AFB9900/iturover-buck-converter/Gorseller/Kart_ustten.png

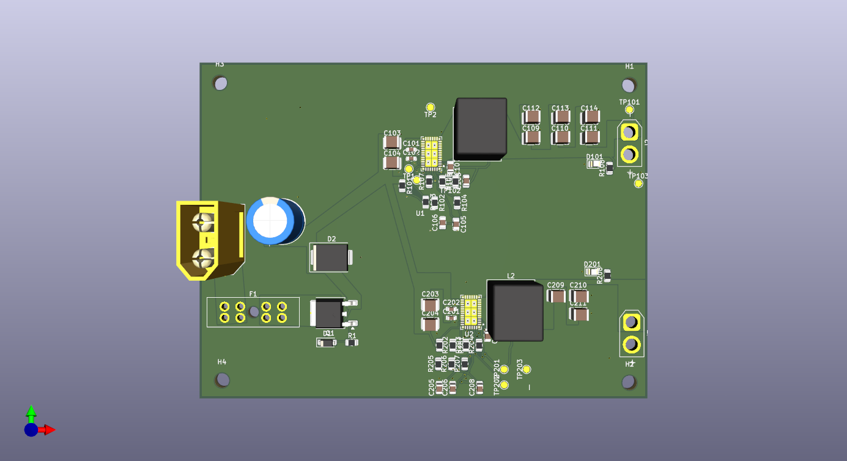
Gorseller/Kart_ustten.png
