AFB9900/iturover-buck-converter/Simulasyon/sim12_acilis_7m.png

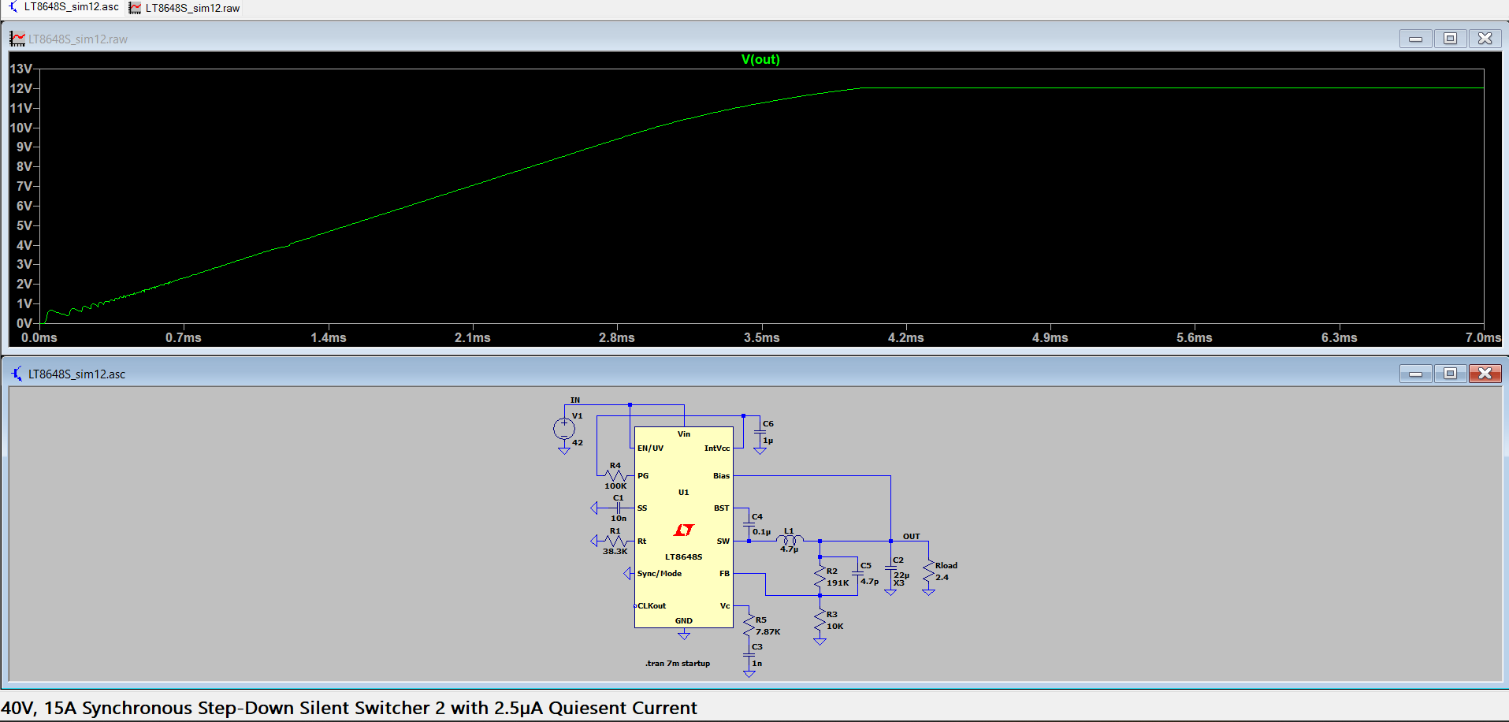
Simulasyon/sim12_acilis_7m.png
