AFB9900/iturover-buck-converter/Simulasyon/sim12_sonuc.png

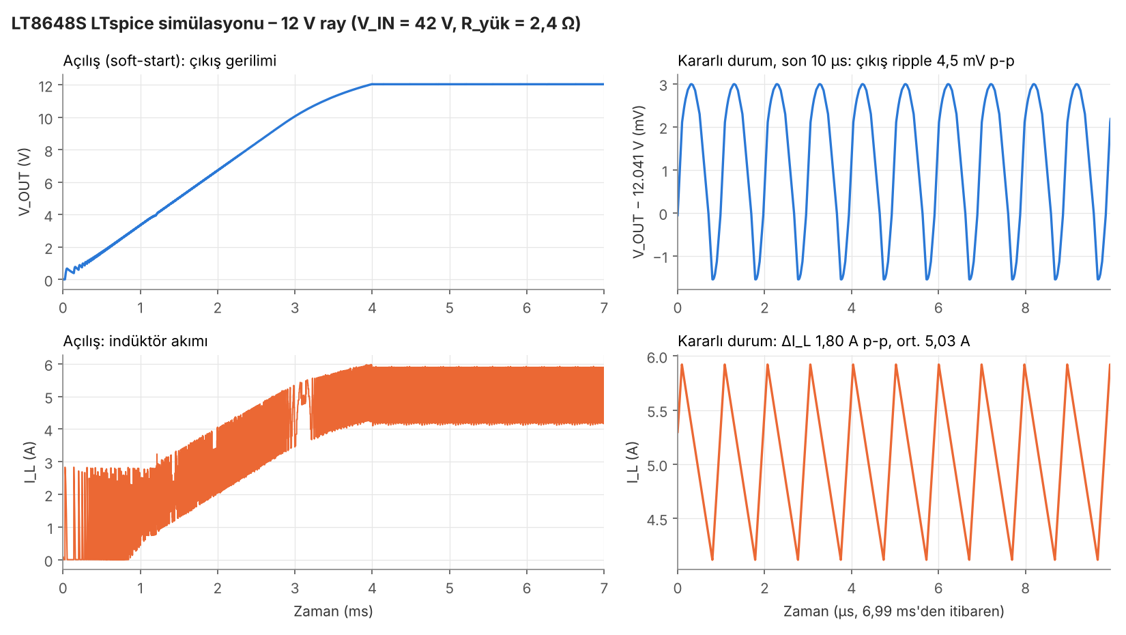
Simulasyon/sim12_sonuc.png
