AFB9900/iturover-buck-converter/Simulasyon/sim24_acilis_7m.png

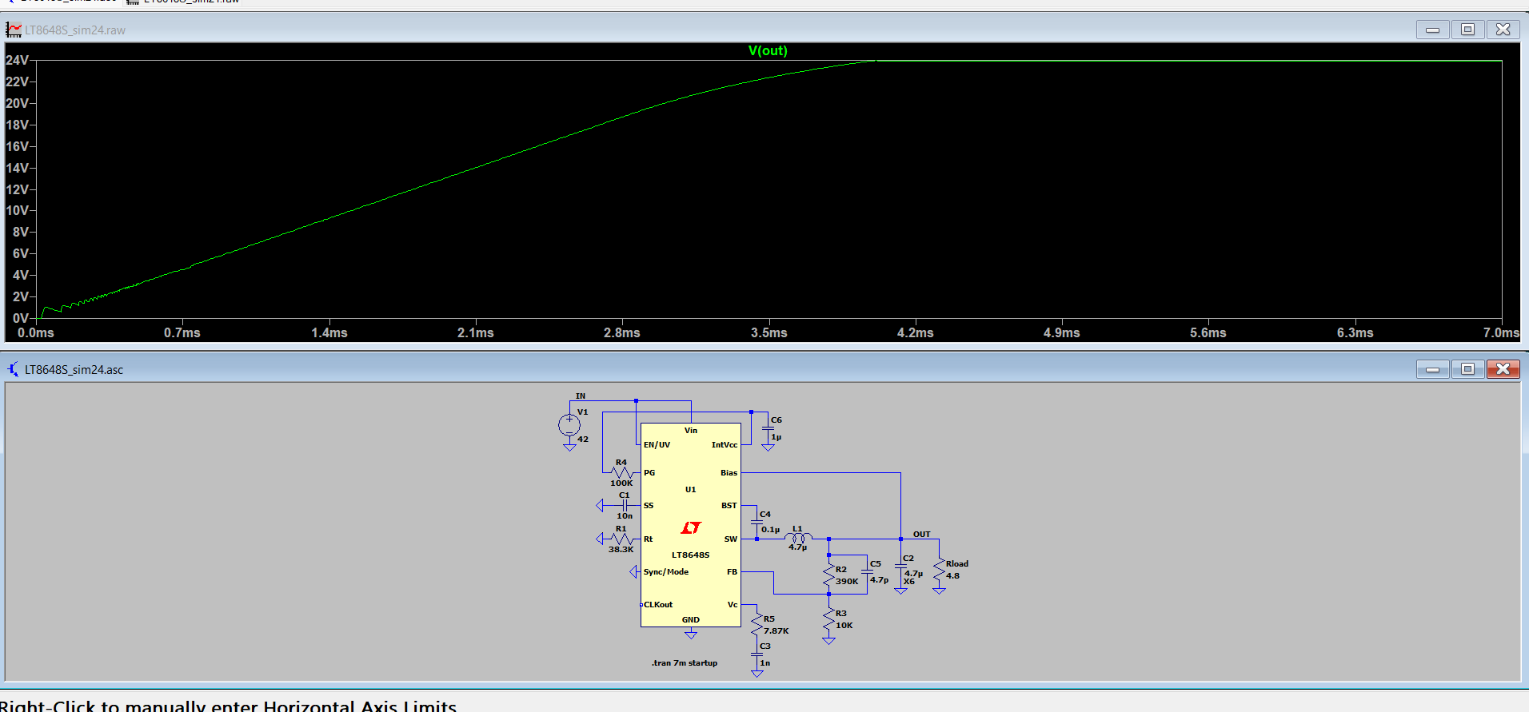
Simulasyon/sim24_acilis_7m.png
