AFB9900/iturover-buck-converter/Uretim_Dosyalari/BOM.csv

Reference | Qty | Value | DNP | Exclude from BOM | Exclude from Board | Footprint | Datasheet
C1 | 1 | 100u 63V |  |  |  | Capacitor_THT:CP_Radial_D10.0mm_P5.00mm | ~
C101,C102,C201,C202 | 4 | 100n 100V X7R |  |  |  | Capacitor_SMD:C_0603_1608Metric | ~
C103,C104,C109,C110,C111,C112,C113,C114,C203,C204 | 10 | 4.7u 50V X7R |  |  |  | Capacitor_SMD:C_1210_3225Metric | ~
C105,C205 | 2 | 10n |  |  |  | Capacitor_SMD:C_0805_2012Metric | ~
C106,C206 | 2 | 1n C0G |  |  |  | Capacitor_SMD:C_0805_2012Metric | ~
C107,C207 | 2 | 1u X7R |  |  |  | Capacitor_SMD:C_0805_2012Metric | ~
C108,C208 | 2 | 4.7p C0G |  |  |  | Capacitor_SMD:C_0805_2012Metric | ~
C209,C210,C211 | 3 | 22u 25V X7R |  |  |  | Capacitor_SMD:C_1210_3225Metric | ~
D1 | 1 | MMSZ5242B 12V |  |  |  | Diode_SMD:D_SOD-123 | ~
D2 | 1 | SMCJ43A |  |  |  | Diode_SMD:D_SMC | ~
D101,D201 | 2 | Yesil LED |  |  |  | LED_SMD:LED_0805_2012Metric | ~
F1 | 1 | 10A ATO |  |  |  | Fuse:FuseHolder_Blade_ATO_Littelfuse_FLR_178.6165 | ~
H1,H2,H3,H4 | 4 | M3 |  |  |  | MountingHole:MountingHole_3.2mm_M3 | ~
J1 | 1 | XT60 batarya girisi (pin1 = +) |  |  |  | Connector_AMASS:AMASS_XT60-M_1x02_P7.20mm_Vertical | ~
J2 | 1 | XT30 24V cikis (pin1 = +) |  |  |  | Connector_AMASS:AMASS_XT30U-F_1x02_P5.0mm_Vertical | ~
J3 | 1 | XT30 12V cikis (pin1 = +) |  |  |  | Connector_AMASS:AMASS_XT30U-F_1x02_P5.0mm_Vertical | ~
L1,L2 | 2 | 4.7u XAL1010-472ME |  |  |  | Inductor_SMD:L_Coilcraft_XAL1010-XXX | ~
Q1 | 1 | SQD50P06-15L |  |  |  | Package_TO_SOT_SMD:TO-252-2 | ~
R1 | 1 | 22k |  |  |  | Resistor_SMD:R_0805_2012Metric | ~
R101,R201 | 2 | 274k 1% |  |  |  | Resistor_SMD:R_0805_2012Metric | ~
R102,R106,R202,R206 | 4 | 10k 1% |  |  |  | Resistor_SMD:R_0805_2012Metric | ~
R103,R203 | 2 | 38.3k 1% |  |  |  | Resistor_SMD:R_0805_2012Metric | ~
R104,R204 | 2 | 7.87k |  |  |  | Resistor_SMD:R_0805_2012Metric | ~
R105 | 1 | 390k 1% |  |  |  | Resistor_SMD:R_0805_2012Metric | ~
R107,R207 | 2 | 100k |  |  |  | Resistor_SMD:R_0805_2012Metric | ~
R108 | 1 | 10k |  |  |  | Resistor_SMD:R_0805_2012Metric | ~
R205 | 1 | 191k 1% |  |  |  | Resistor_SMD:R_0805_2012Metric | ~
R208 | 1 | 4.7k |  |  |  | Resistor_SMD:R_0805_2012Metric | ~
TP1 | 1 | VIN |  |  |  | TestPoint:TestPoint_Pad_D1.5mm | ~
TP2,TP103,TP203 | 3 | GND |  |  |  | TestPoint:TestPoint_Pad_D1.5mm | ~
TP101 | 1 | 24V |  |  |  | TestPoint:TestPoint_Pad_D1.5mm | ~
TP102,TP202 | 2 | PG |  |  |  | TestPoint:TestPoint_Pad_D1.5mm | ~
TP201 | 1 | 12V |  |  |  | TestPoint:TestPoint_Pad_D1.5mm | ~
U1,U2 | 2 | LT8648S |  |  |  | LT8648S:IC_LT8648SEV_TRPBF | https://s3.amazonaws.com/snapeda/datasheet/LT8648SEV_TRPBF_Analog_Devices-_Inc.pdf
