AFB9900/iturover-buck-converter/Gorseller/Sematik.pdf

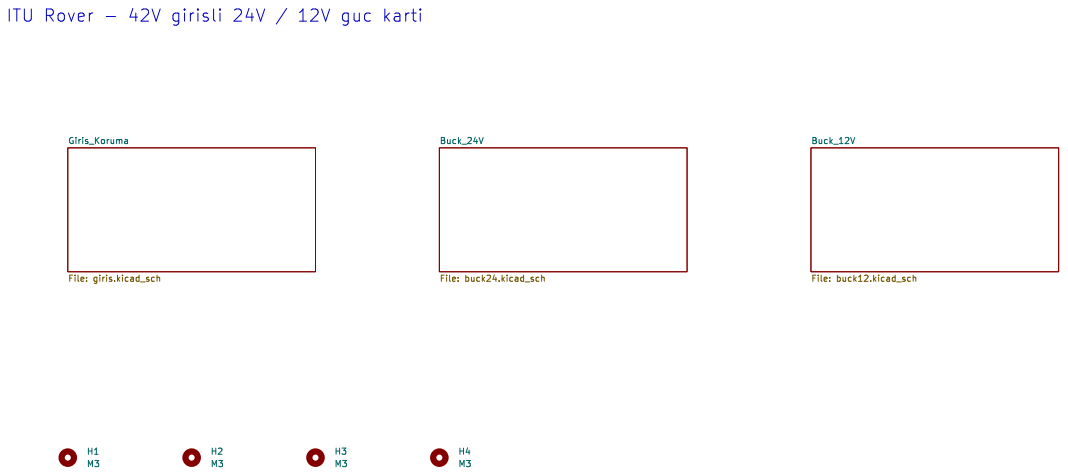
[picture p17: page 1]

Id: 1/4 Title: Guc karti - ana sayfa

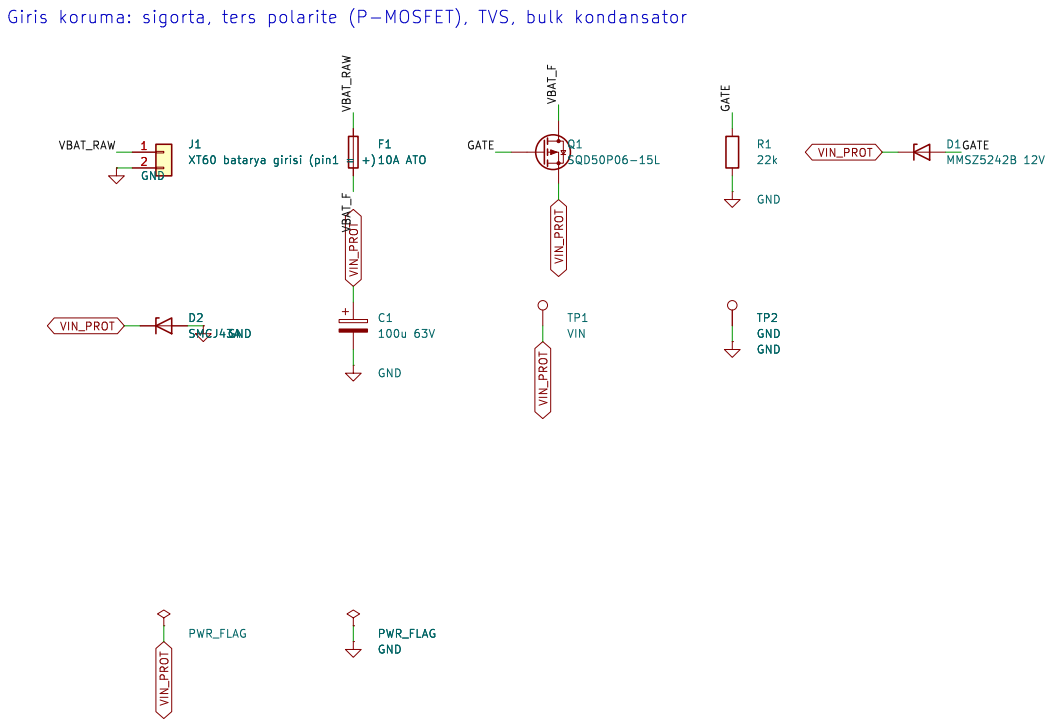
[picture p18: page 2]

File: giris.kicad_sch Sheet: /Giris_Koruma/
Id: 2/4 Title: Giris koruma

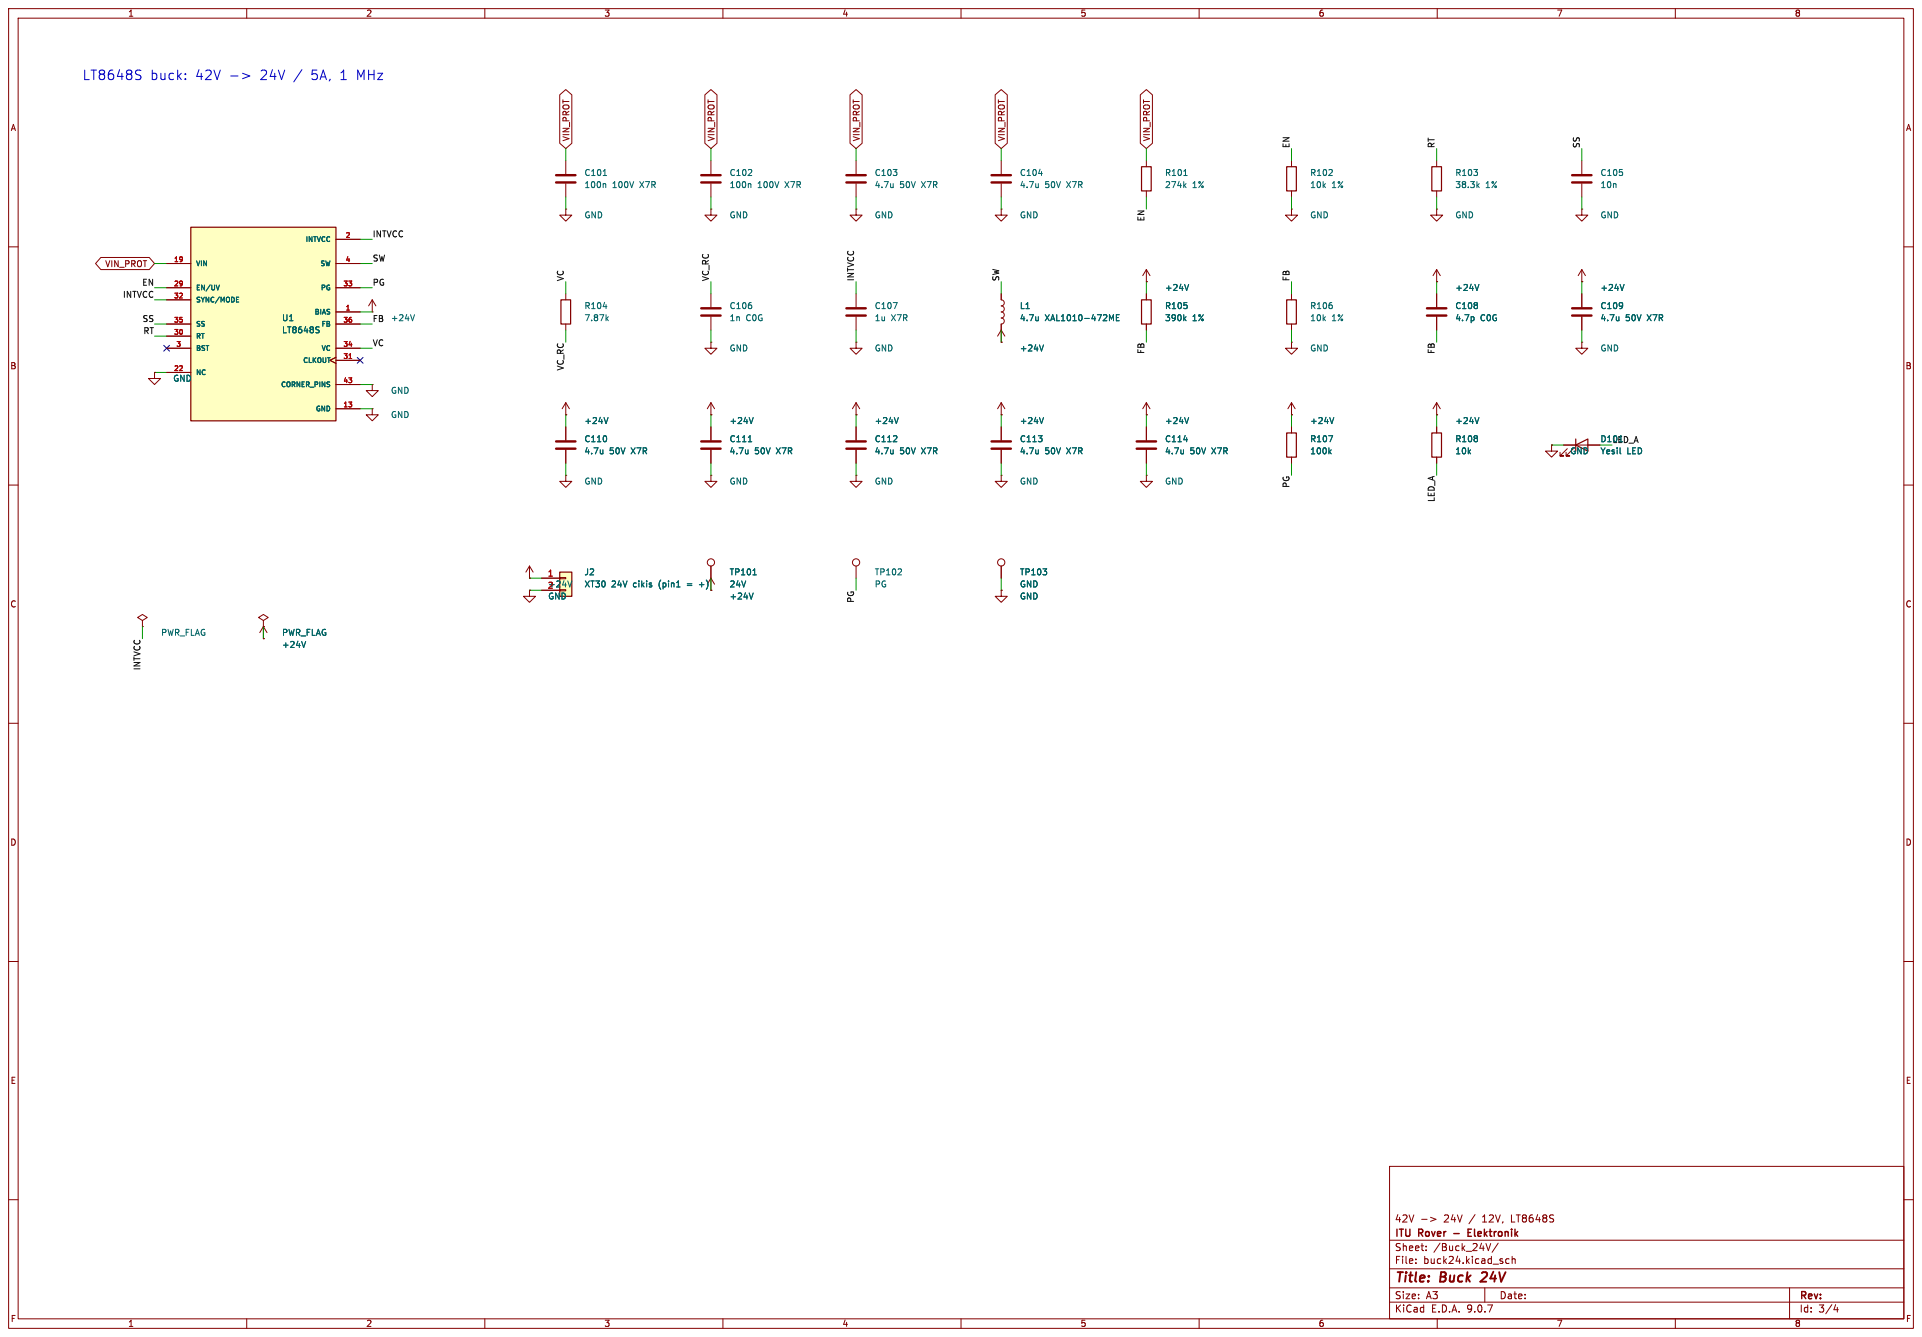
[picture p19: page 3]

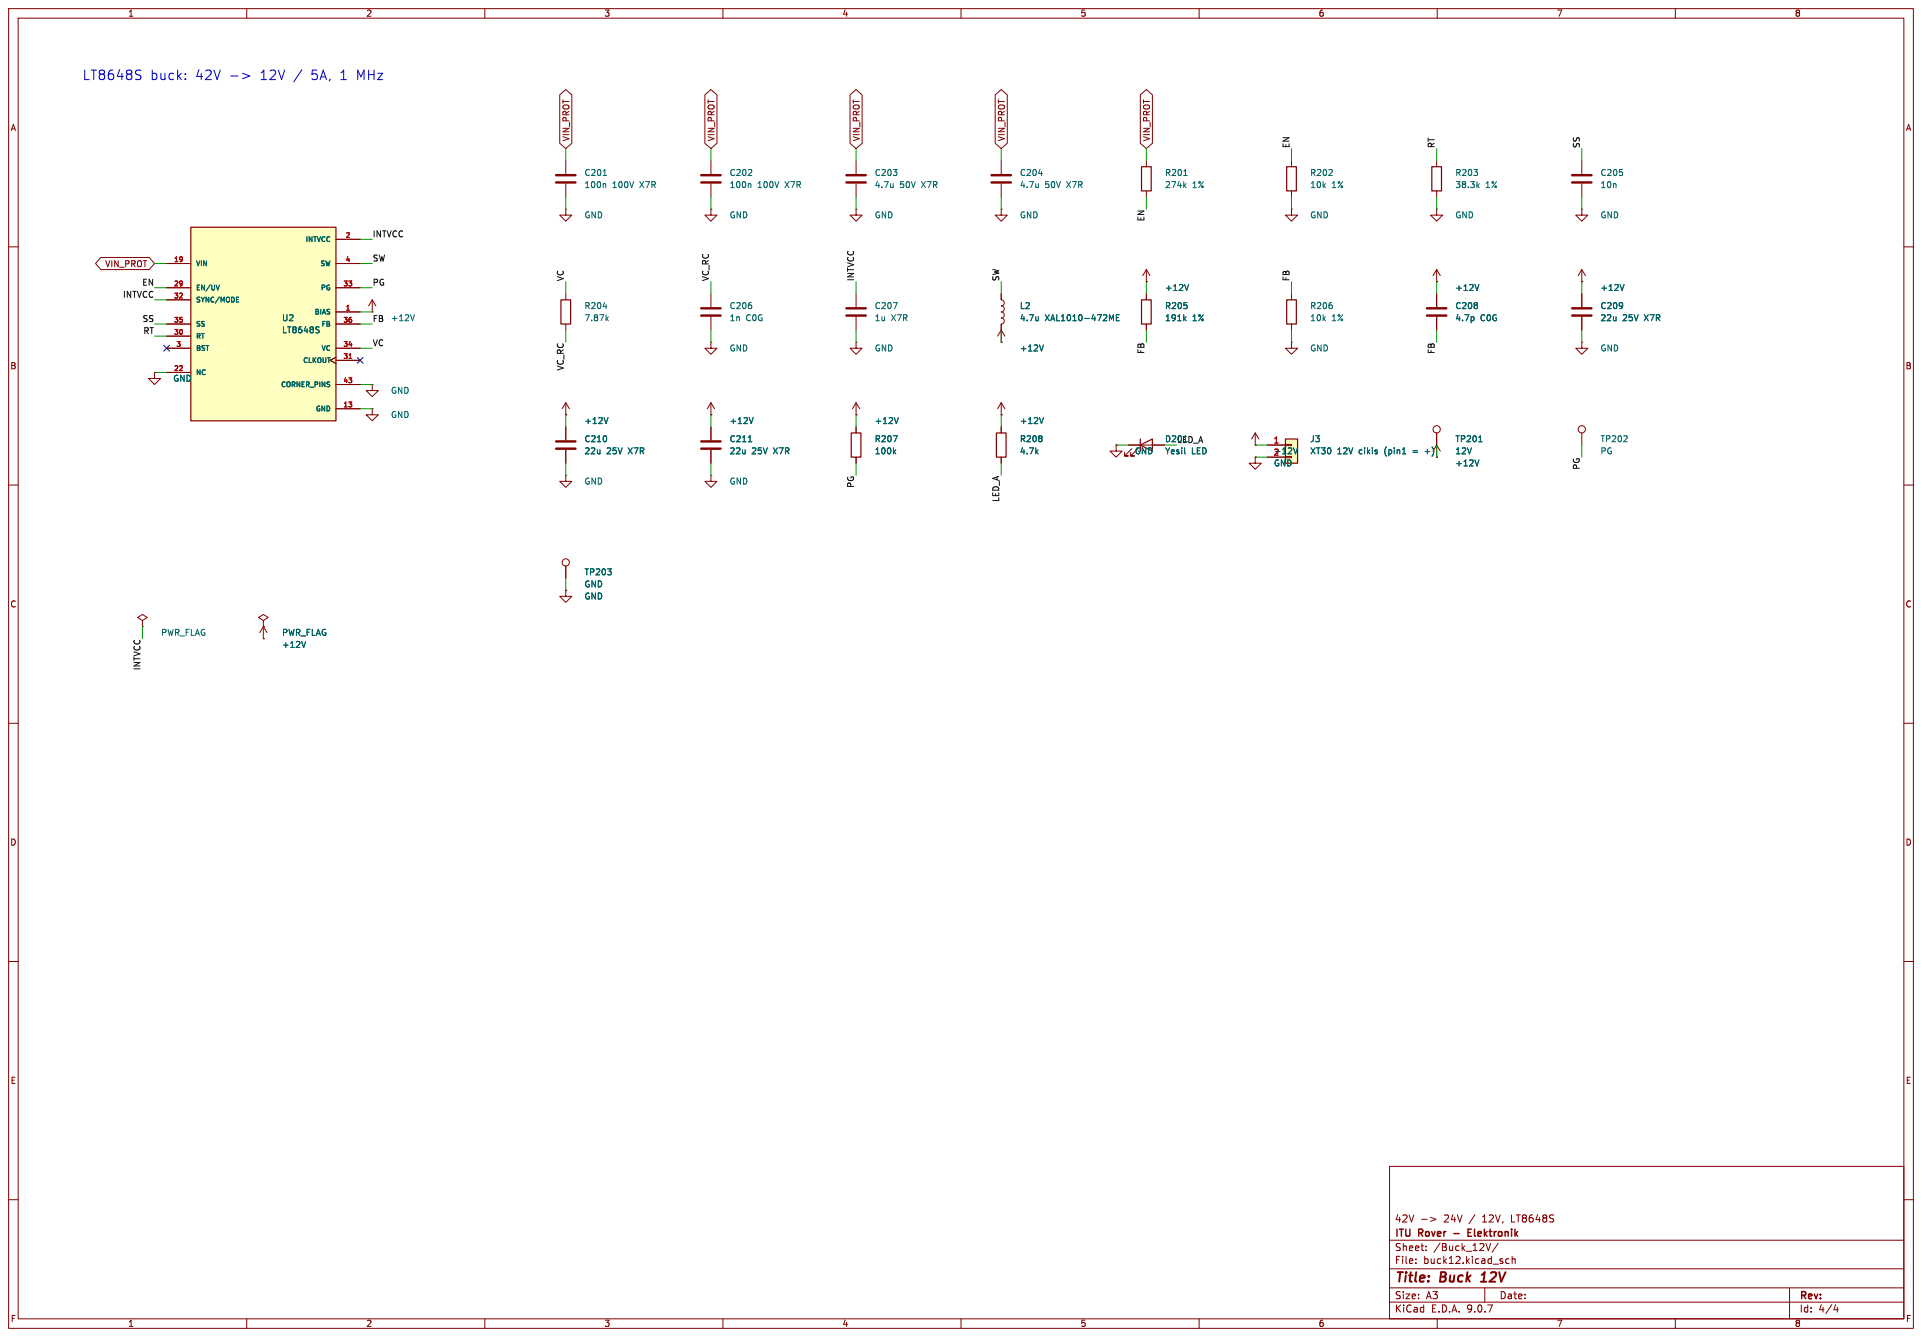
[picture p20: page 4]
