AFB9900/iturover-buck-converter/Simulasyon/LT8648S_sim24.asc

C1: cap; 10n
C2: cap; 4.7µ; X6; Rser=6m
C3: cap; 1n
C4: cap; 0.1µ
C5: cap; 4.7p
C6: cap; 1µ
L1: ind; 4.7µ; Rser=5m
R1: res; 38.3K
R2: res; 390K
R3: res; 10K
R4: res; 100K
R5: res; 7.87K
Rload: res; 4.8
U1: LT8648S
V1: voltage; 42
Named nets: 0, OUT, IN
.tran 7m startup
