AFB9900/iturover-buck-converter/KiCad_Proje/BuckConvertor.kicad_pcb

## KiCad design KiCad_Proje/BuckConvertor.kicad_pcb (2026-11-07)

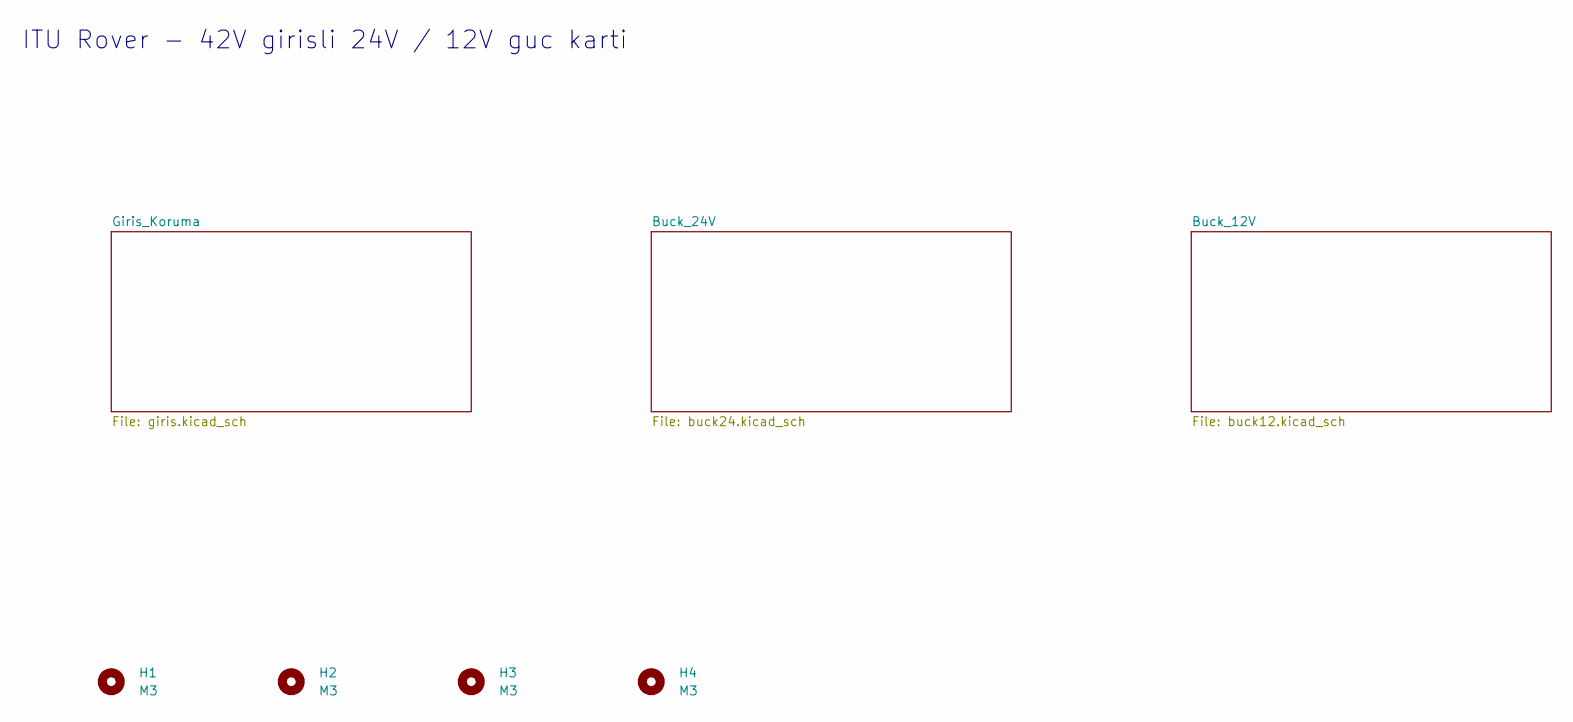
[picture p21: schematic BuckConvertor.kicad_sch, Guc karti - ana sayfa]

Parts:
H1, H2, H3, H4: M3; MountingHole_3.2mm_M3

Notes on the sheet:
ITU Rover - 42V girisli 24V / 12V guc karti

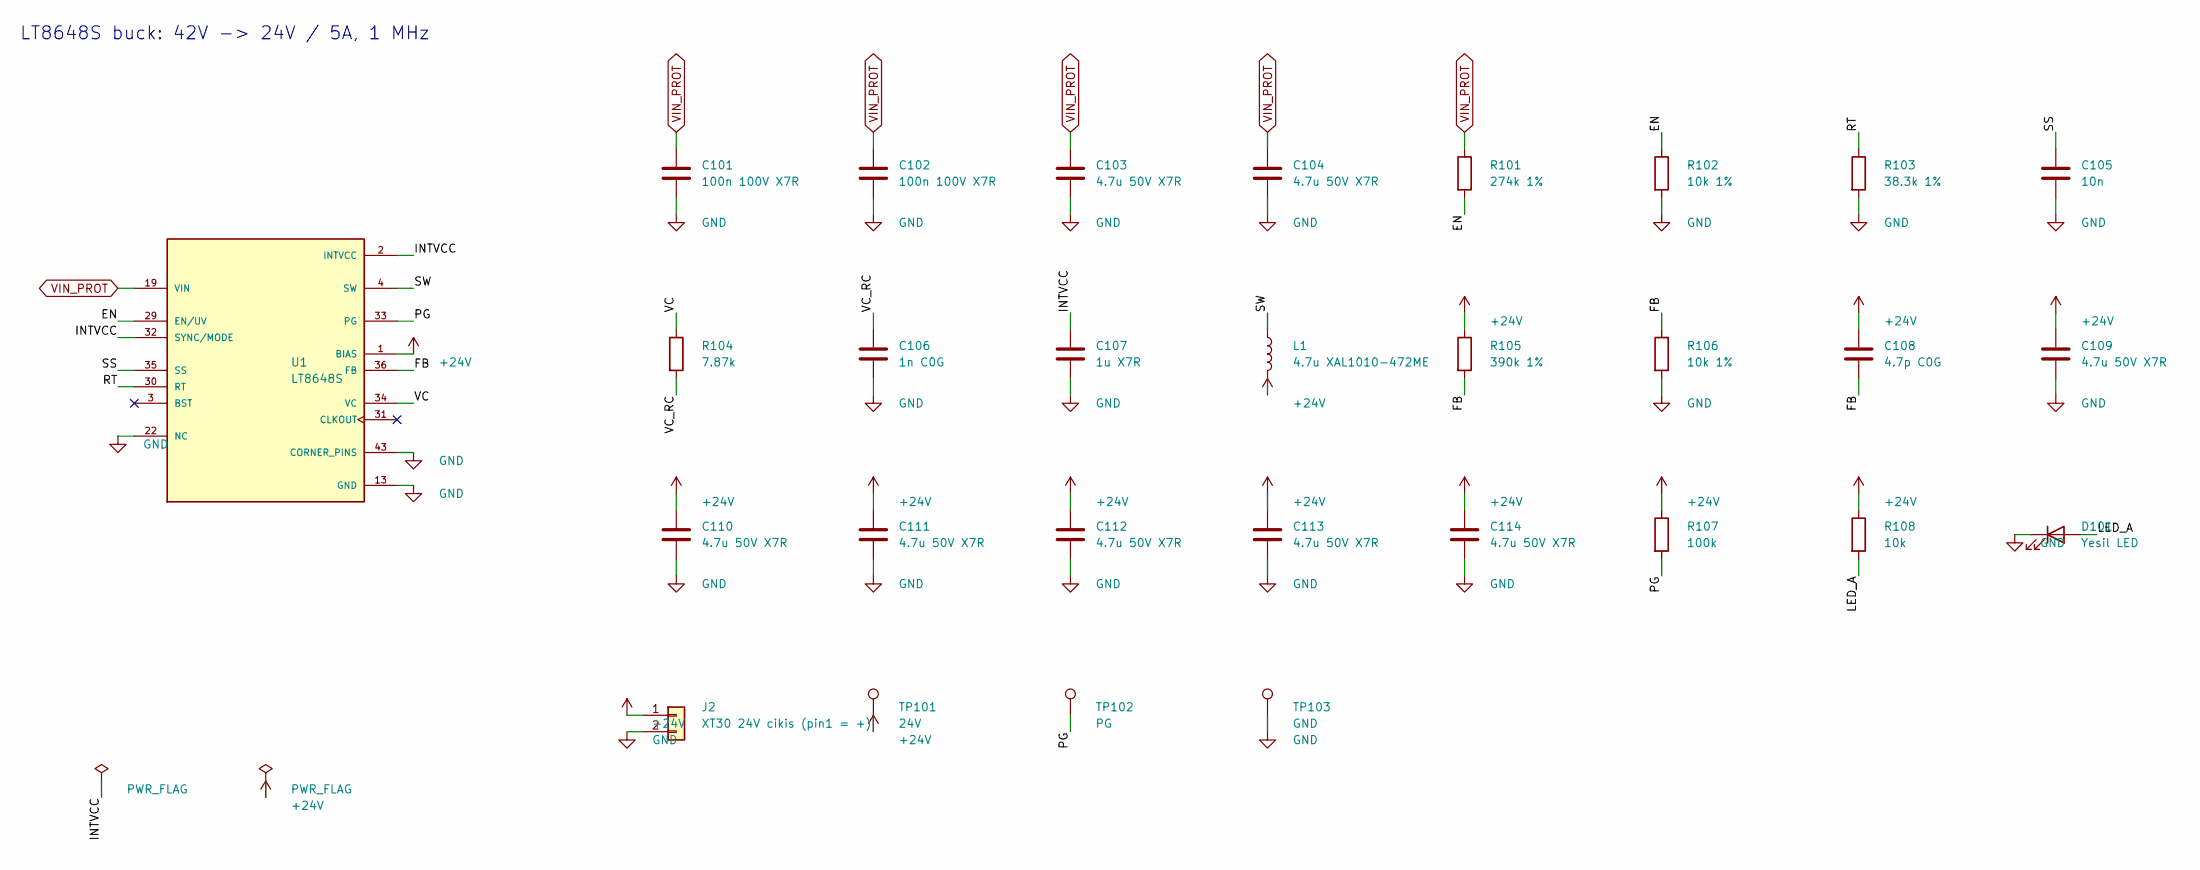
[picture p22: schematic buck24.kicad_sch, Buck 24V]

Parts:
C101, C102: 100n 100V X7R; C_0603_1608Metric
C103, C104, C109, C110, C111, C112, C113, C114: 4.7u 50V X7R; C_1210_3225Metric
C105: 10n; C_0805_2012Metric
C106: 1n C0G; C_0805_2012Metric
C107: 1u X7R; C_0805_2012Metric
C108: 4.7p C0G; C_0805_2012Metric
D101: Yesil LED; LED_0805_2012Metric
J2: XT30 24V cikis (pin1 = +); AMASS_XT30U-F_1x02_P5.0mm_Vertical
L1: 4.7u XAL1010-472ME; L_Coilcraft_XAL1010-XXX
R101: 274k 1%; R_0805_2012Metric
R102, R106: 10k 1%; R_0805_2012Metric
R103: 38.3k 1%; R_0805_2012Metric
R104: 7.87k; R_0805_2012Metric
R105: 390k 1%; R_0805_2012Metric
R107: 100k; R_0805_2012Metric
R108: 10k; R_0805_2012Metric
TP101: 24V; TestPoint_Pad_D1.5mm
TP102: PG; TestPoint_Pad_D1.5mm
TP103: GND; TestPoint_Pad_D1.5mm
U1: LT8648S; IC_LT8648SEV_TRPBF; MPN LT8648SEV#TRPBF

Connections:
+24V: C108.1, C109.1, C110.1, C111.1, C112.1, C113.1, C114.1, J2.1, L1.2, R105.1, R107.1, R108.1, TP101.1, U1.1 (BIAS)
/Buck_24V/EN: R101.2, R102.1, U1.29 (EN/UV)
/Buck_24V/FB: C108.2, R105.2, R106.1, U1.36 (FB)
/Buck_24V/INTVCC: C107.1, U1.2 (INTVCC), U1.32 (SYNC/MODE)
/Buck_24V/LED_A: D101.2 (A), R108.2
/Buck_24V/PG: R107.2, TP102.1, U1.33 (PG)
/Buck_24V/RT: R103.1, U1.30 (RT)
/Buck_24V/SS: C105.1, U1.35 (SS)
/Buck_24V/SW: L1.1, U1.4 (SW), U1.5 (SW), U1.6 (SW), U1.7 (SW), U1.8 (SW), U1.9 (SW), U1.10 (SW), U1.11 (SW), U1.12 (SW)
/Buck_24V/VC: R104.1, U1.34 (VC)
/Buck_24V/VC_RC: C106.1, R104.2
GND: C101.2, C102.2, C103.2, C104.2, C105.2, C106.2, C107.2, C109.2, C110.2, C111.2, C112.2, C113.2, C114.2, D101.1 (K), J2.2, R102.2, R103.2, R106.2, TP103.1, U1.13 (GND), U1.14 (GND), U1.15 (GND), U1.16 (GND), U1.17 (GND), U1.18 (GND), U1.22 (NC), U1.23 (GND), U1.24 (GND), U1.25 (NC), U1.37 (GND), U1.38 (GND), U1.39 (GND), U1.40 (GND), U1.41 (GND), U1.42 (GND), U1.43 (CORNER_PINS), U1.44 (CORNER_PINS), U1.45 (CORNER_PINS), U1.46 (CORNER_PINS); also elsewhere on the board
VIN_PROT: C101.1, C102.1, C103.1, C104.1, R101.1, U1.19 (VIN), U1.20 (VIN), U1.21 (VIN), U1.26 (VIN), U1.27 (VIN), U1.28 (VIN); also elsewhere on the board

Notes on the sheet:
LT8648S buck: 42V -> 24V / 5A, 1 MHz

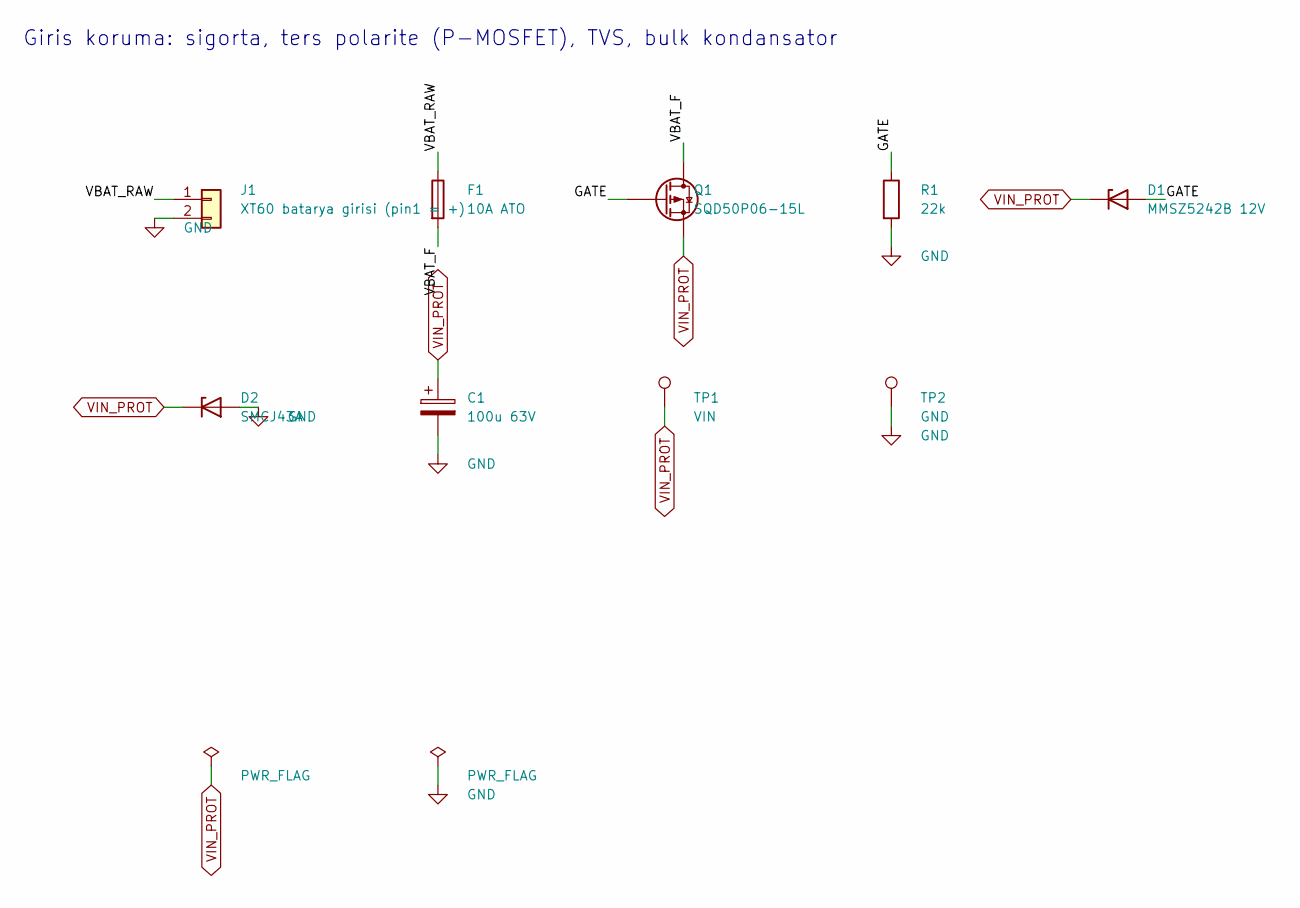
[picture p23: schematic giris.kicad_sch, Giris koruma]

Parts:
C1: 100u 63V; CP_Radial_D10.0mm_P5.00mm
D1: MMSZ5242B 12V; D_SOD-123
D2: SMCJ43A; D_SMC
F1: 10A ATO; FuseHolder_Blade_ATO_Littelfuse_FLR_178.6165
J1: XT60 batarya girisi (pin1 = +); AMASS_XT60-M_1x02_P7.20mm_Vertical
Q1: SQD50P06-15L; TO-252-2
R1: 22k; R_0805_2012Metric
TP1: VIN; TestPoint_Pad_D1.5mm
TP2: GND; TestPoint_Pad_D1.5mm

Connections:
/Giris_Koruma/GATE: D1.2 (A), Q1.1 (G), R1.1
/Giris_Koruma/VBAT_F: F1.2, Q1.2 (D)
/Giris_Koruma/VBAT_RAW: F1.1, J1.1
GND: C1.2, D2.2 (A), J1.2, R1.2, TP2.1; also elsewhere on the board
VIN_PROT: C1.1, D1.1 (K), D2.1 (K), Q1.3 (S), TP1.1; also elsewhere on the board

Notes on the sheet:
Giris koruma: sigorta, ters polarite (P-MOSFET), TVS, bulk kondansator

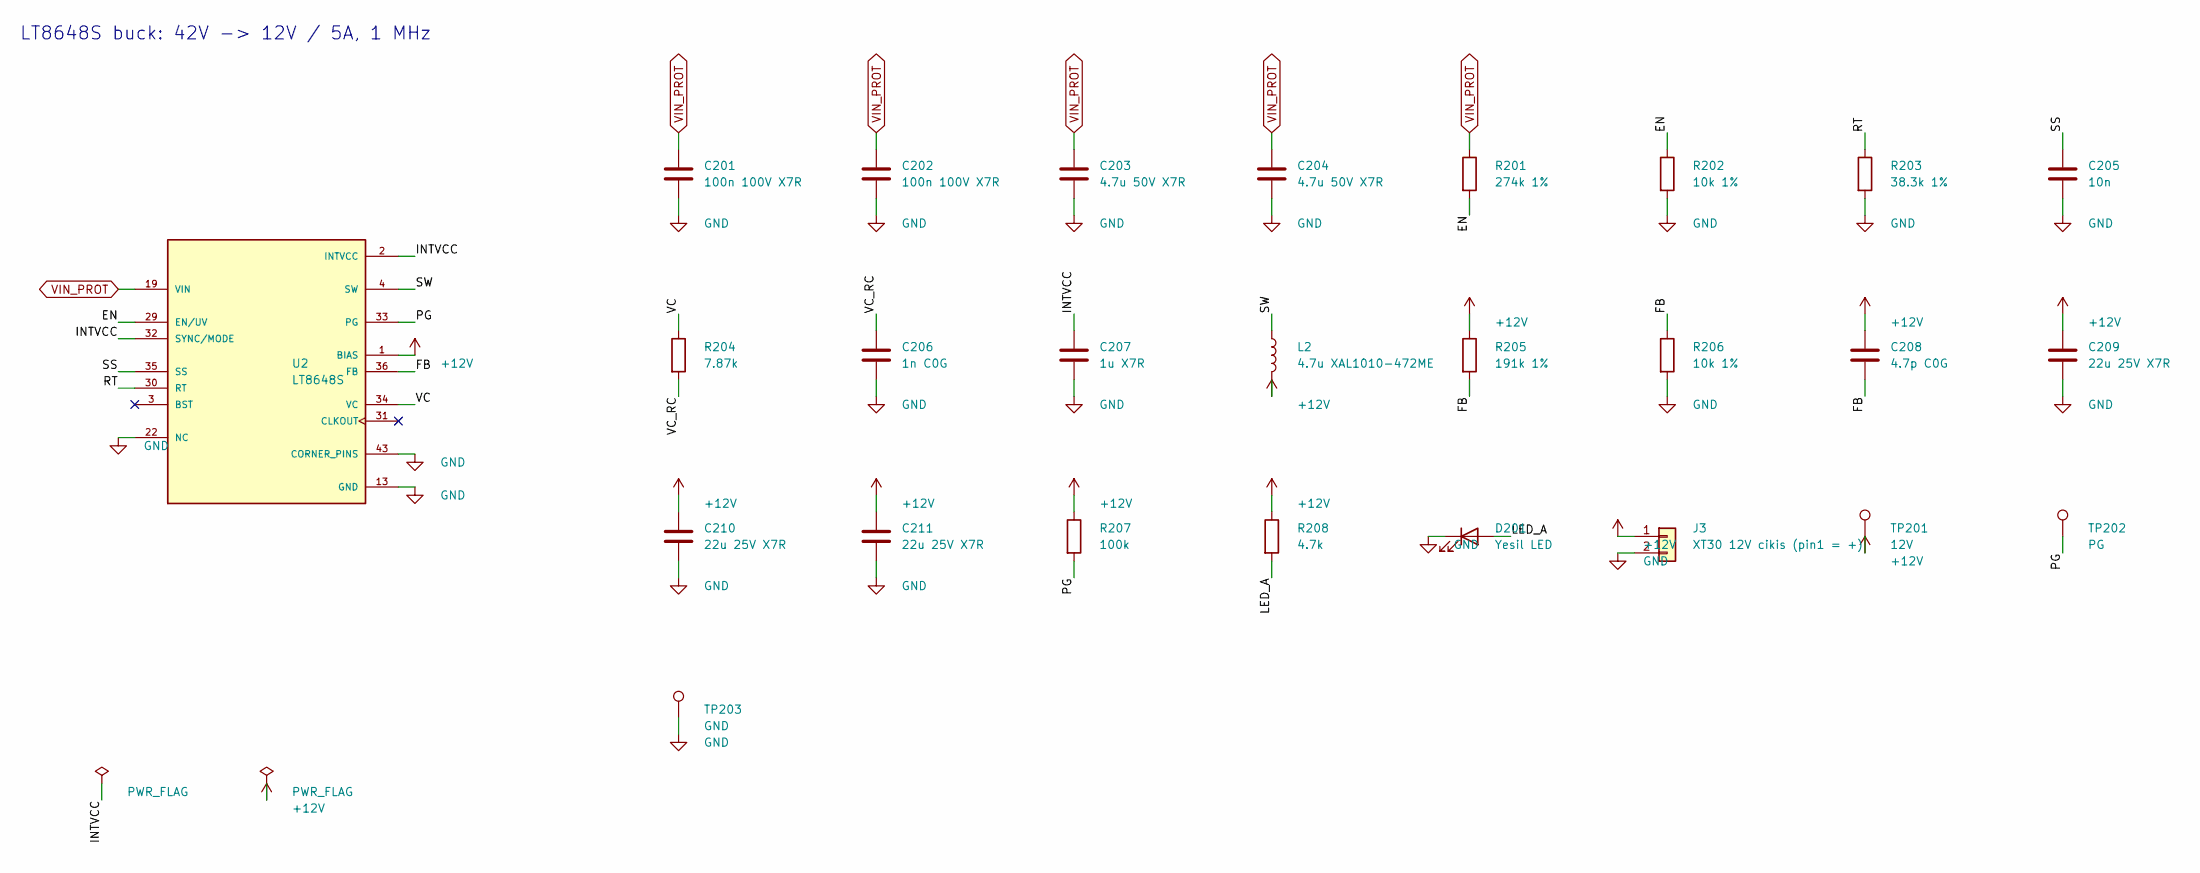
[picture p24: schematic buck12.kicad_sch, Buck 12V]

Parts:
C201, C202: 100n 100V X7R; C_0603_1608Metric
C203, C204: 4.7u 50V X7R; C_1210_3225Metric
C205: 10n; C_0805_2012Metric
C206: 1n C0G; C_0805_2012Metric
C207: 1u X7R; C_0805_2012Metric
C208: 4.7p C0G; C_0805_2012Metric
C209, C210, C211: 22u 25V X7R; C_1210_3225Metric
D201: Yesil LED; LED_0805_2012Metric
J3: XT30 12V cikis (pin1 = +); AMASS_XT30U-F_1x02_P5.0mm_Vertical
L2: 4.7u XAL1010-472ME; L_Coilcraft_XAL1010-XXX
R201: 274k 1%; R_0805_2012Metric
R202, R206: 10k 1%; R_0805_2012Metric
R203: 38.3k 1%; R_0805_2012Metric
R204: 7.87k; R_0805_2012Metric
R205: 191k 1%; R_0805_2012Metric
R207: 100k; R_0805_2012Metric
R208: 4.7k; R_0805_2012Metric
TP201: 12V; TestPoint_Pad_D1.5mm
TP202: PG; TestPoint_Pad_D1.5mm
TP203: GND; TestPoint_Pad_D1.5mm
U2: LT8648S; IC_LT8648SEV_TRPBF; MPN LT8648SEV#TRPBF

Connections:
+12V: C208.1, C209.1, C210.1, C211.1, J3.1, L2.2, R205.1, R207.1, R208.1, TP201.1, U2.1 (BIAS)
/Buck_12V/EN: R201.2, R202.1, U2.29 (EN/UV)
/Buck_12V/FB: C208.2, R205.2, R206.1, U2.36 (FB)
/Buck_12V/INTVCC: C207.1, U2.2 (INTVCC), U2.32 (SYNC/MODE)
/Buck_12V/LED_A: D201.2 (A), R208.2
/Buck_12V/PG: R207.2, TP202.1, U2.33 (PG)
/Buck_12V/RT: R203.1, U2.30 (RT)
/Buck_12V/SS: C205.1, U2.35 (SS)
/Buck_12V/SW: L2.1, U2.4 (SW), U2.5 (SW), U2.6 (SW), U2.7 (SW), U2.8 (SW), U2.9 (SW), U2.10 (SW), U2.11 (SW), U2.12 (SW)
/Buck_12V/VC: R204.1, U2.34 (VC)
/Buck_12V/VC_RC: C206.1, R204.2
GND: C201.2, C202.2, C203.2, C204.2, C205.2, C206.2, C207.2, C209.2, C210.2, C211.2, D201.1 (K), J3.2, R202.2, R203.2, R206.2, TP203.1, U2.13 (GND), U2.14 (GND), U2.15 (GND), U2.16 (GND), U2.17 (GND), U2.18 (GND), U2.22 (NC), U2.23 (GND), U2.24 (GND), U2.25 (NC), U2.37 (GND), U2.38 (GND), U2.39 (GND), U2.40 (GND), U2.41 (GND), U2.42 (GND), U2.43 (CORNER_PINS), U2.44 (CORNER_PINS), U2.45 (CORNER_PINS), U2.46 (CORNER_PINS); also elsewhere on the board
VIN_PROT: C201.1, C202.1, C203.1, C204.1, R201.1, U2.19 (VIN), U2.20 (VIN), U2.21 (VIN), U2.26 (VIN), U2.27 (VIN), U2.28 (VIN); also elsewhere on the board

Notes on the sheet:
LT8648S buck: 42V -> 12V / 5A, 1 MHz

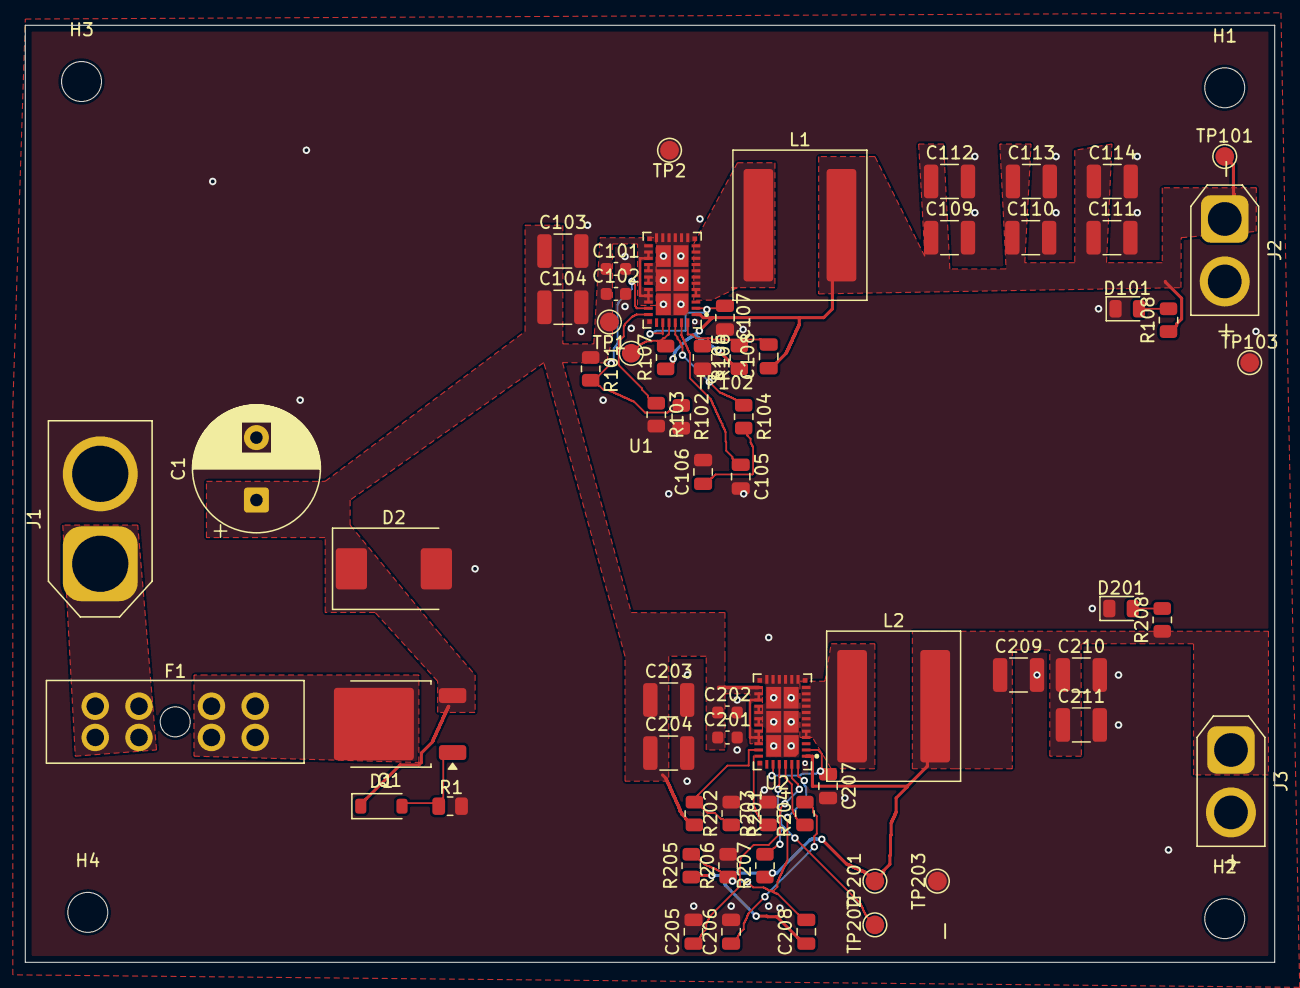
[picture p25: board BuckConvertor.kicad_pcb from above]

Board: 4 copper layers, 100.0 x 75.0 mm, 68 parts (0 on the bottom side), 27 nets.
